Cloud-Lightning/HPM5E31_PCB/HPM5E31.kicad_pcb

## KiCad design HPM5E31.kicad_pcb (continued)

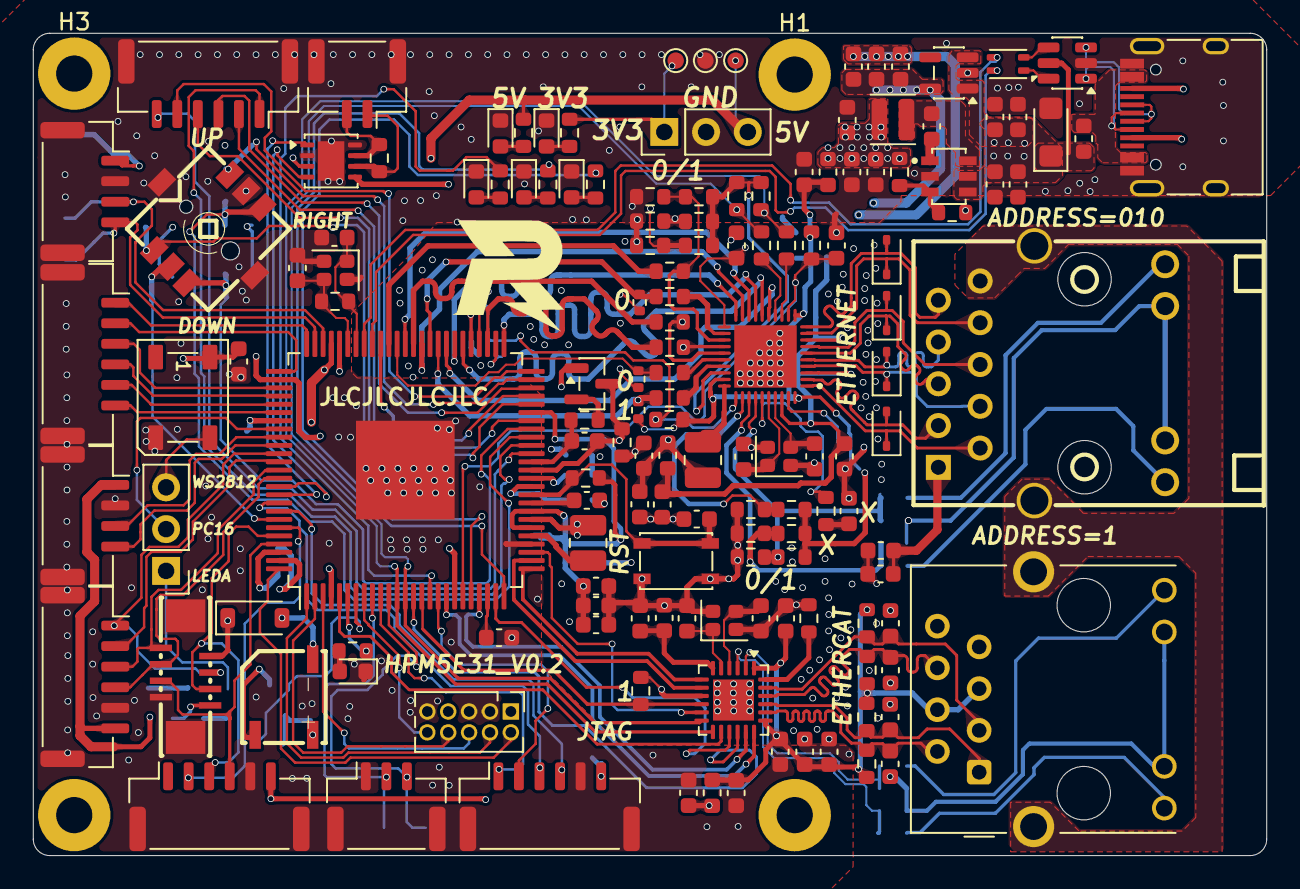
[picture p7: board HPM5E31.kicad_pcb from above]

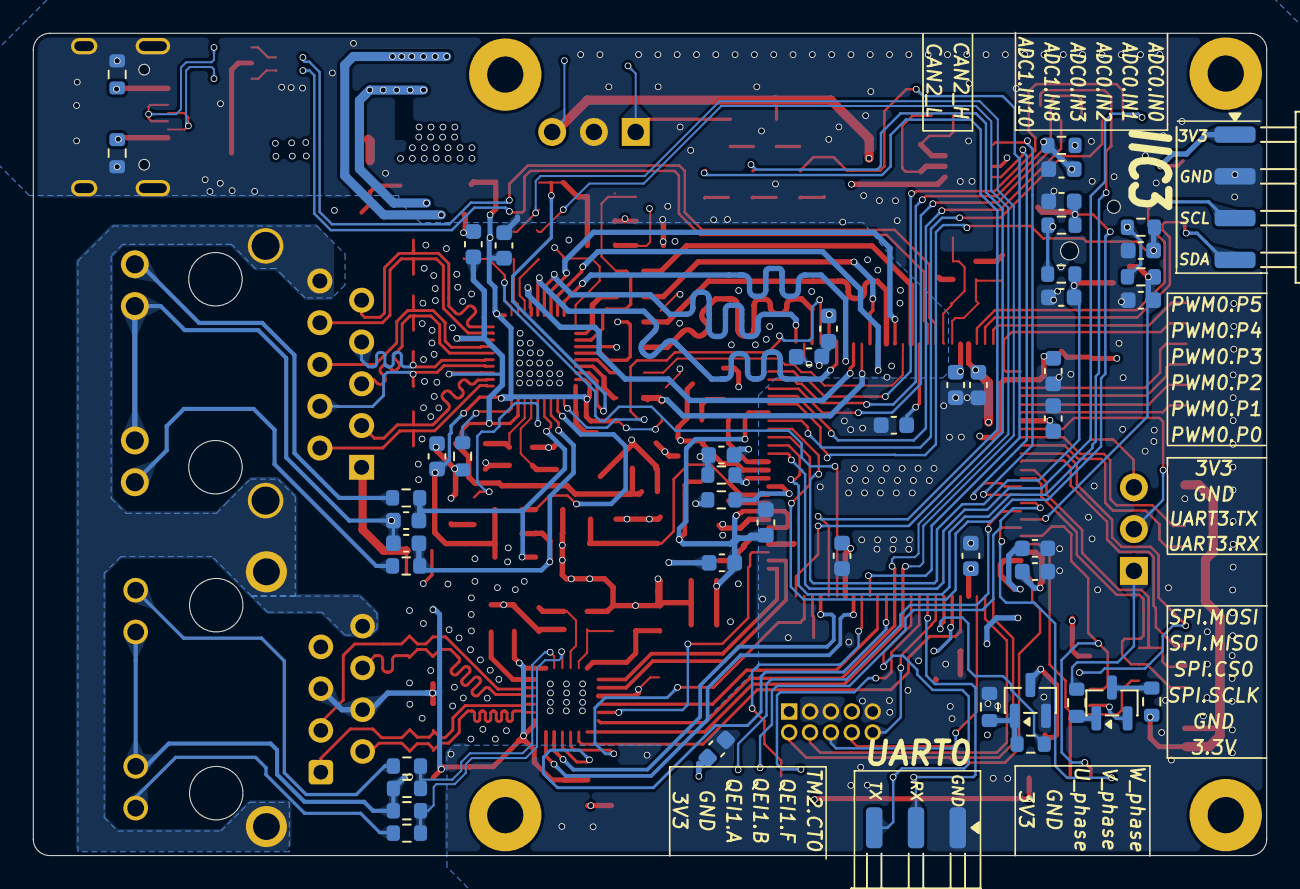
[picture p8: board HPM5E31.kicad_pcb from below]

Board: 4 copper layers, 75.0 x 50.0 mm, 201 parts (49 on the bottom side), 163 nets.
