Cloud-Lightning/HPM5E31_PCB/(commit log)

2026-04-04 demo第一版
    [HPM5E31-B_Cu.gbr, HPM5E31-B_Mask.gbr, HPM5E31-B_Paste.gbr, HPM5E31-B_Silkscreen.gbr, HPM5E31-Edge_Cuts.gbr, HPM5E31-F_Cu.gbr, HPM5E31-F_Mask.gbr, HPM5E31-F_Paste.gbr]
2026-04-04 modify silkscreen printing
    [HPM5E31-B_Cu.gbr, HPM5E31-B_Mask.gbr, HPM5E31-B_Paste.gbr, HPM5E31-B_Silkscreen.gbr, HPM5E31-Edge_Cuts.gbr, HPM5E31-F_Cu.gbr, HPM5E31-F_Mask.gbr, HPM5E31-F_Paste.gbr]
2026-04-09 add pin description
    [PIN_F.kicad_sch]
2026-04-15 修改错误引脚
    [HPM5E31-B_Cu.gbr, HPM5E31-B_Mask.gbr, HPM5E31-B_Paste.gbr, HPM5E31-B_Silkscreen.gbr, HPM5E31-Edge_Cuts.gbr, HPM5E31-F_Cu.gbr, HPM5E31-F_Mask.gbr, HPM5E31-F_Paste.gbr]
